FylloClip/FylloClip-foliar-sensor/README.md

> ⚠️ **Important:** This repository is deprecated. 

The current and fully maintained version of the FylloClip documentation, including step-by-step instructions for building, programming, and deploying the sensor, is available here:

➡️ https://fylloclip.github.io/tutorial/

Source code and project files are available here:
https://github.com/FylloClip/tutorial

## What happened?

This repository represents an early development stage of the FylloClip foliar sensor project.  
Since then, the documentation has been significantly improved, restructured, and expanded to provide a clearer and more user-friendly tutorial.

## Content of this repository

This repository is preserved for reference purposes and may contain:
- early versions of the Arduino code
- initial PCB designs
- legacy documentation

⚠️ Please note that parts of this repository may be outdated or incomplete.

## 🔒 Status

This repository has been archived and is read-only.  
No further updates or support will be provided here.
