FylloClip/FylloClip-foliar-sensor/Tutorial/FylloClip - components – 2024.pdf

# FylloClip hardware overview

## the main components

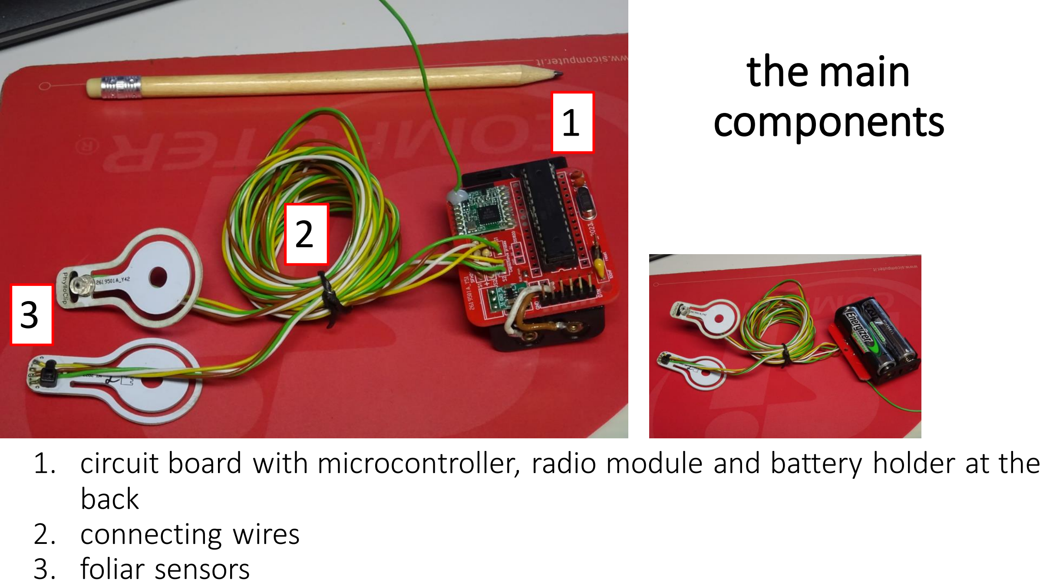
[picture p1: page 2]

1. circuit board with microcontroller, radio module and battery holder at the back
2. connecting wires
3. foliar sensors

1

2

3

## The printed circuit board (PCB)

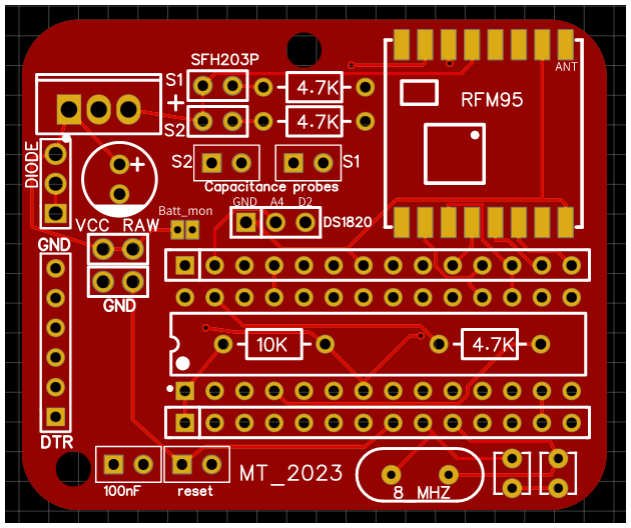
[picture p2: figure]

It holds and connects the various electronic parts of the system:
- voltage regulator
- the ATMEGA328P-PU microcontroller
- the RFM95 LoRa module
- a few other peripheral components (crystal, resistors, capacitors, connectors, antenna...

## The main components of the circut board

Atmega328P-PU with 8 Mhz crystal and 2 capacitors (22pF)

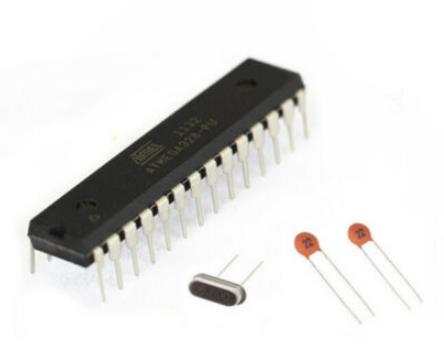
[picture p3: figure]

RFM95w LoRa module (868 Mhz Europe, 915 Mhz Australia)

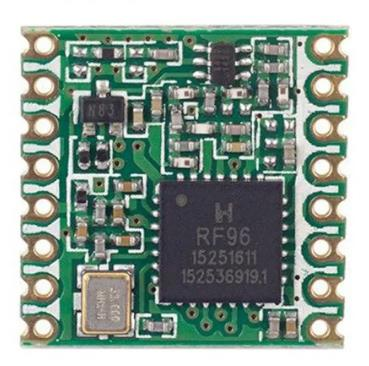
[picture p4: figure]

Voltage regulator (boost DC-DC converter)

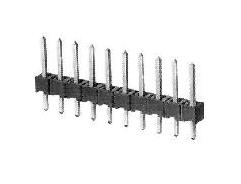
[picture p5: figure]

a few resistors, capacitors, connectors

## The foliar sensor

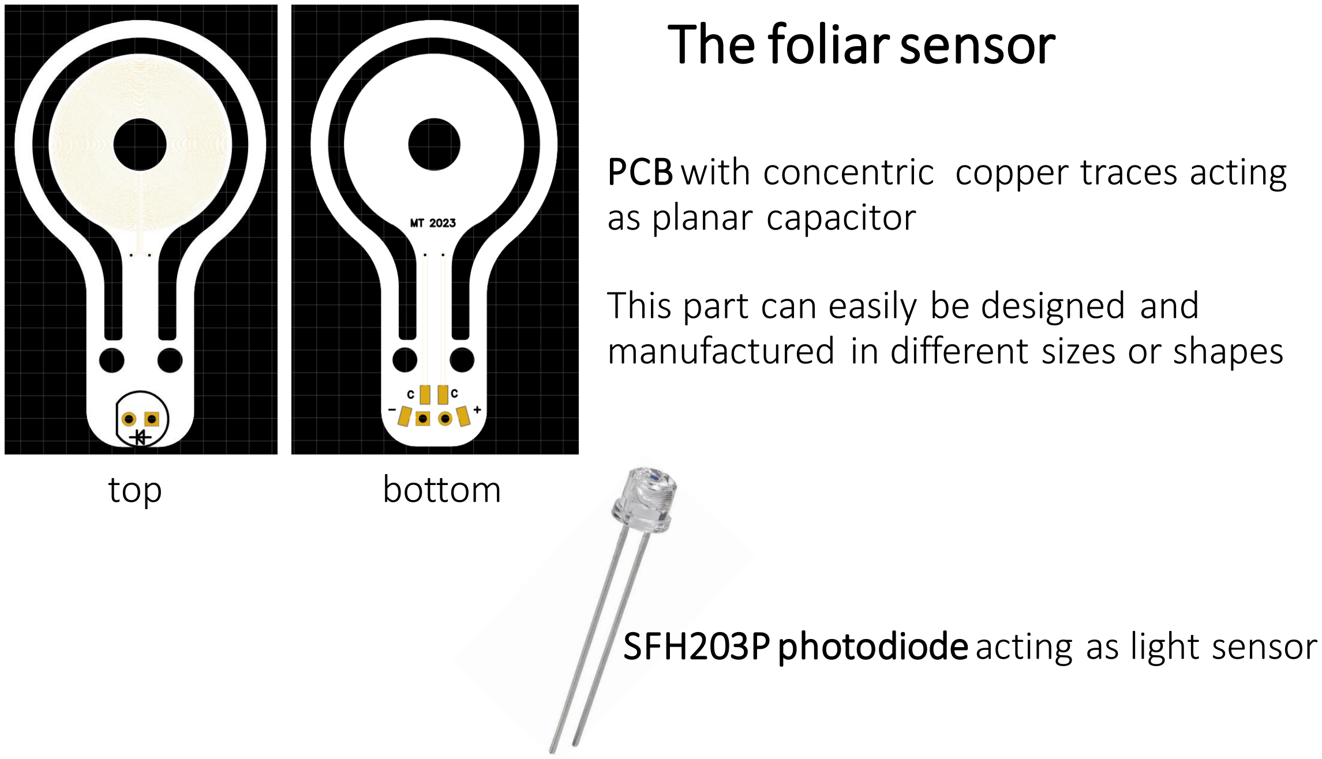
[picture p6: page 5]

PCB with concentric copper traces acting as planar capacitor

This part can easily be designed and manufactured in different sizes or shapes

SFH203P photodiode acting as light sensor

top | bottom

component | link
photodiode | https://www.reichelt.com (https://www.reichelt.com/it/de/silizium-pin-fotodiode-400-1100nm-150-5-mm-sfh-203-p-p60569.html?CCOUNTRY=446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)
microcontroller atmega328 with bootloader for Arduino Pro Mini 3.3V | https://www.reichelt.com(you (https://www.reichelt.com/it/de/8-bit-atmega-avr-mikrocontroller-32-kb-20-mhz-pdip-28-atmega-328p-pu-p119685.html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) need to burn the bootloader onto the chip by yourself)
battery holder | https://www.reichelt.com (https://www.reichelt.com/it/de/batteriehalter-fuer-2-mignonzellen-aa--halter-2xaaz-p113169.html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)
Crystal 8 Mhz | https://www.reichelt.com (https://www.reichelt.com/it/de/standardquarz-grundton-8-000000-mhz-8-0000-hc49u-s-p32845.html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)
LoRa mosule RFM95w | https://www.soselectronic.com (https://www.soselectronic.com/de/products/hoperf/rfm95w-868-s2r-1-180936?query=rfm95w)
Socket for microcontroller | https://www.reichelt.com
Male header pins | https://www.reichelt.com
Female header pins | https://www.reichelt.com/it/de/buchsenleiste-2-54mm-1x20-trennbar-verzinnt-fis-bl1-20-z-p283794.html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 (https://www.reichelt.com/it/de/buchsenleiste-2-54mm-1x20-trennbar-verzinnt-fis-bl1-20-z-p283794.html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) (only in case you want to use female headers for the serial port)
Resistor 4.7K | https://www.reichelt.com (https://www.reichelt.com/it/de/widerstand-kohleschicht-4-7-kohm-0207-250-mw-5--1-4w-4-7k-p1425.html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)
Resistor 10K | https://www.reichelt.com (https://www.reichelt.com/it/de/widerstand-kohleschicht-10-kohm-0207-250-mw-5--1-4w-10k-p1338.html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)
Capacitor 100nF | https://www.reichelt.com (https://www.reichelt.com/it/de/vielschicht-kerko-100-nf-50-100-v-z5u-20-rm-2-5-z5u-2-5-100n-p22977.html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)
Capacitor 22pF | https://www.reichelt.com (https://www.reichelt.com/it/de/keramik-kondensator-22-pf-10-npo-500-v-rm-5-kerko-500-22p-p9330.html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)
Step-up voltage regulator | https://www.aliexpress.com (https://www.aliexpress.com/item/1005005528299048.html?src=google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)

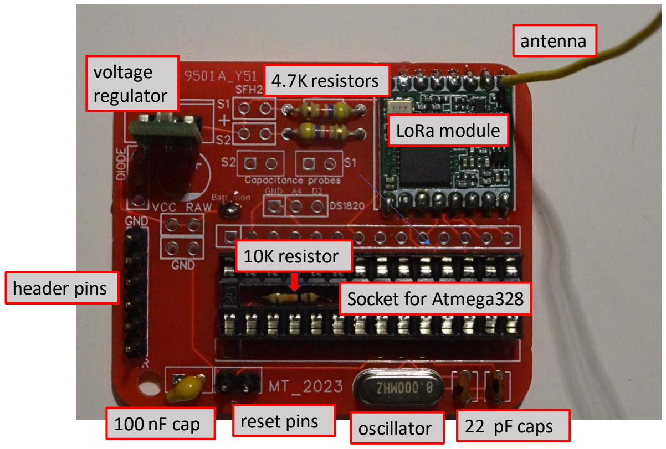
[picture p7: page 7]

LoRa module

Socket for Atmega328

10K resistor

4.7K resistors voltage
regulator

header pins

100 nF cap | reset pins | oscillator | 22 pF caps

antenna

## Wiring connections

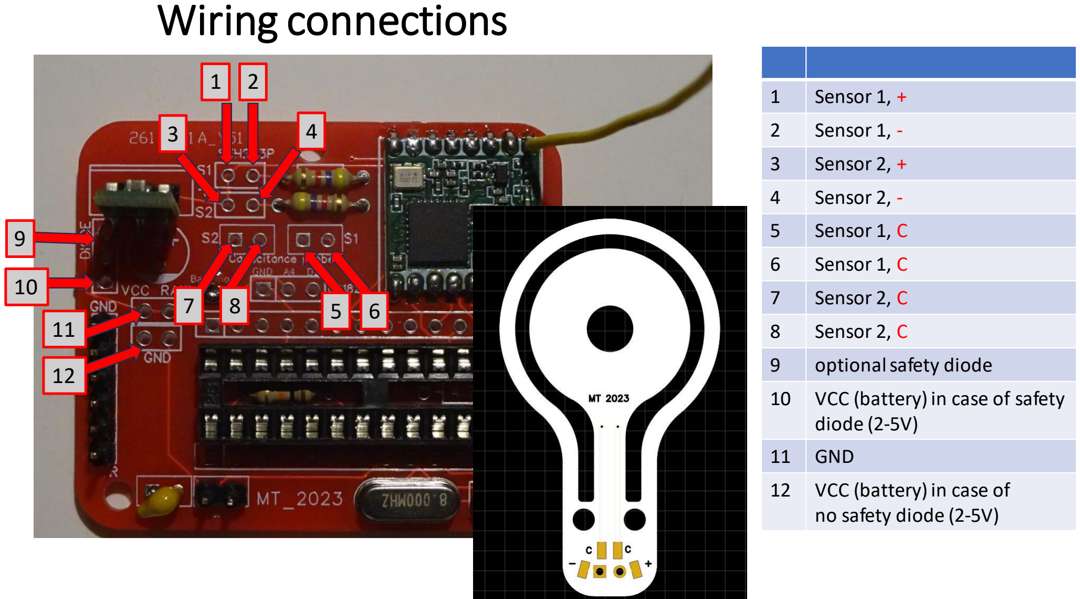
[picture p8: page 8]

1 Sensor 1,

+
2 Sensor 1,
3 | Sensor 2, +
4 | Sensor 2, -
5 | Sensor 1, C
6 | Sensor 1, C
7 | Sensor 2, C
8 | Sensor 2, C
9 | optional safety diode
10 | VCC (battery) in case of safety diode (2 -5V)
11 | GND
12 | VCC (battery) in case of no safety diode (2 -5V)

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
## Wiring diagram

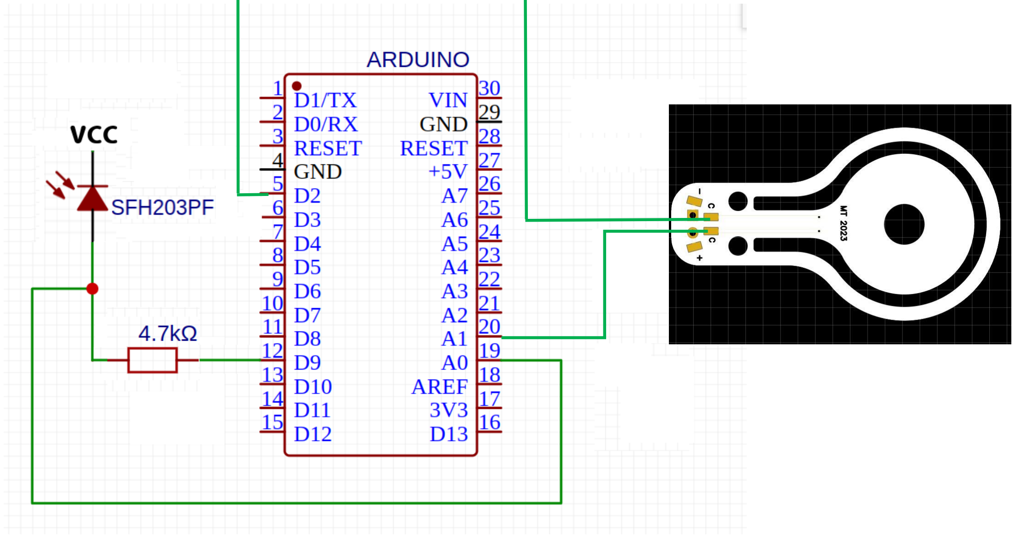
[picture p9: figure]
