FylloClip/FylloClip-foliar-sensor/(list of files, drawings)

Other design files:
PCB production files/Arduino_board/EasyEda/PCB_Arduino_LoRa_board.json
PCB production files/foliar_sensor/EasyEda/larger_size_sensor.json
PCB production files/foliar_sensor/EasyEda/small_size_sensor.json
