FylloClip/FylloClip-foliar-sensor/(commit log)

2023-12-13 Create folder Arduino board PCB
2023-12-13 change directory structure
    [larger_size_sensor.json, small_size_sensor.json]
2024-01-21 Add files via upload
    short videoclip showing how to solder the LoRa module onto the PCB
2024-05-21 Update FylloClip - components – 2024.pdf
